hanhanhan-kim/cold_stage/plots/temps_vs_time_for_PWM/temps_vs_time_for_PWM_000.png

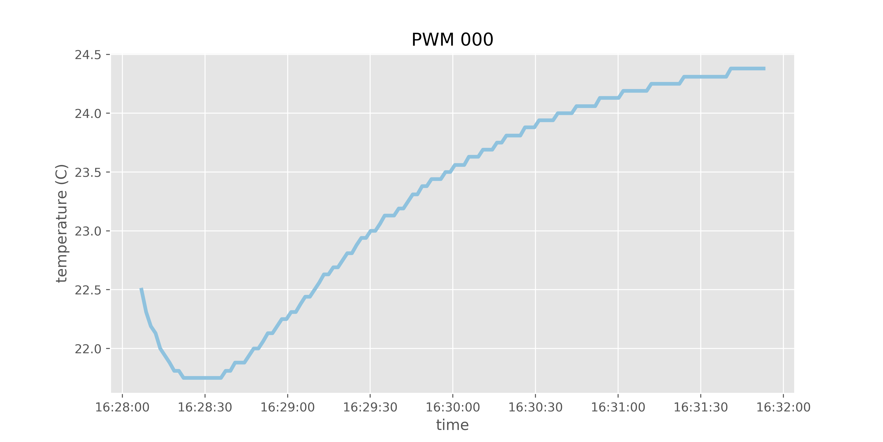
plots/temps_vs_time_for_PWM/temps_vs_time_for_PWM_000.png
