hanhanhan-kim/cold_stage/(commit log)

2020-07-02 add feedfwd calibration data
2020-07-02 replace txt data with csvs
    [pwm_000.csv, pwm_001.csv, pwm_003.csv, pwm_007.csv, pwm_015.csv, pwm_031.csv, pwm_063.csv, pwm_127.csv]
2020-07-02 add csv version
    [bangbang_loop_setpoint_17C_demo.csv]
2020-07-02 init script for making pwm temp timeseries
2020-07-02 init lookup table for pwm temps
2020-07-02 rename file
    [PWMs_vs_temps.csv]
2020-07-02 init linear regression on PWMs vs temps
2020-07-02 edit x axis label
2020-07-02 fix error in FF fxn
    [pwm_dc_ds18b20_FF_P_loop.ino]
2020-07-02 reorganize subdirs
    [pwm_000.csv, pwm_001.csv, pwm_003.csv, pwm_007.csv, pwm_015.csv, pwm_031.csv, pwm_063.csv, pwm_127.csv]
2020-07-02 add csvs of gains
    [gain_10.csv, gain_2.csv, gain_50.csv]
2020-07-02 replace txt data for csvs
    [gain_02.csv]
2020-07-03 rename vars and delete prints
2020-07-03 change var names and rm print lines
